AEFeinstein/Swadge-Programmer-Chainsaw/swadge-programmer/swadge-programmer.kicad_pcb

## KiCad design swadge-programmer/swadge-programmer.kicad_pcb (2021-10-04)

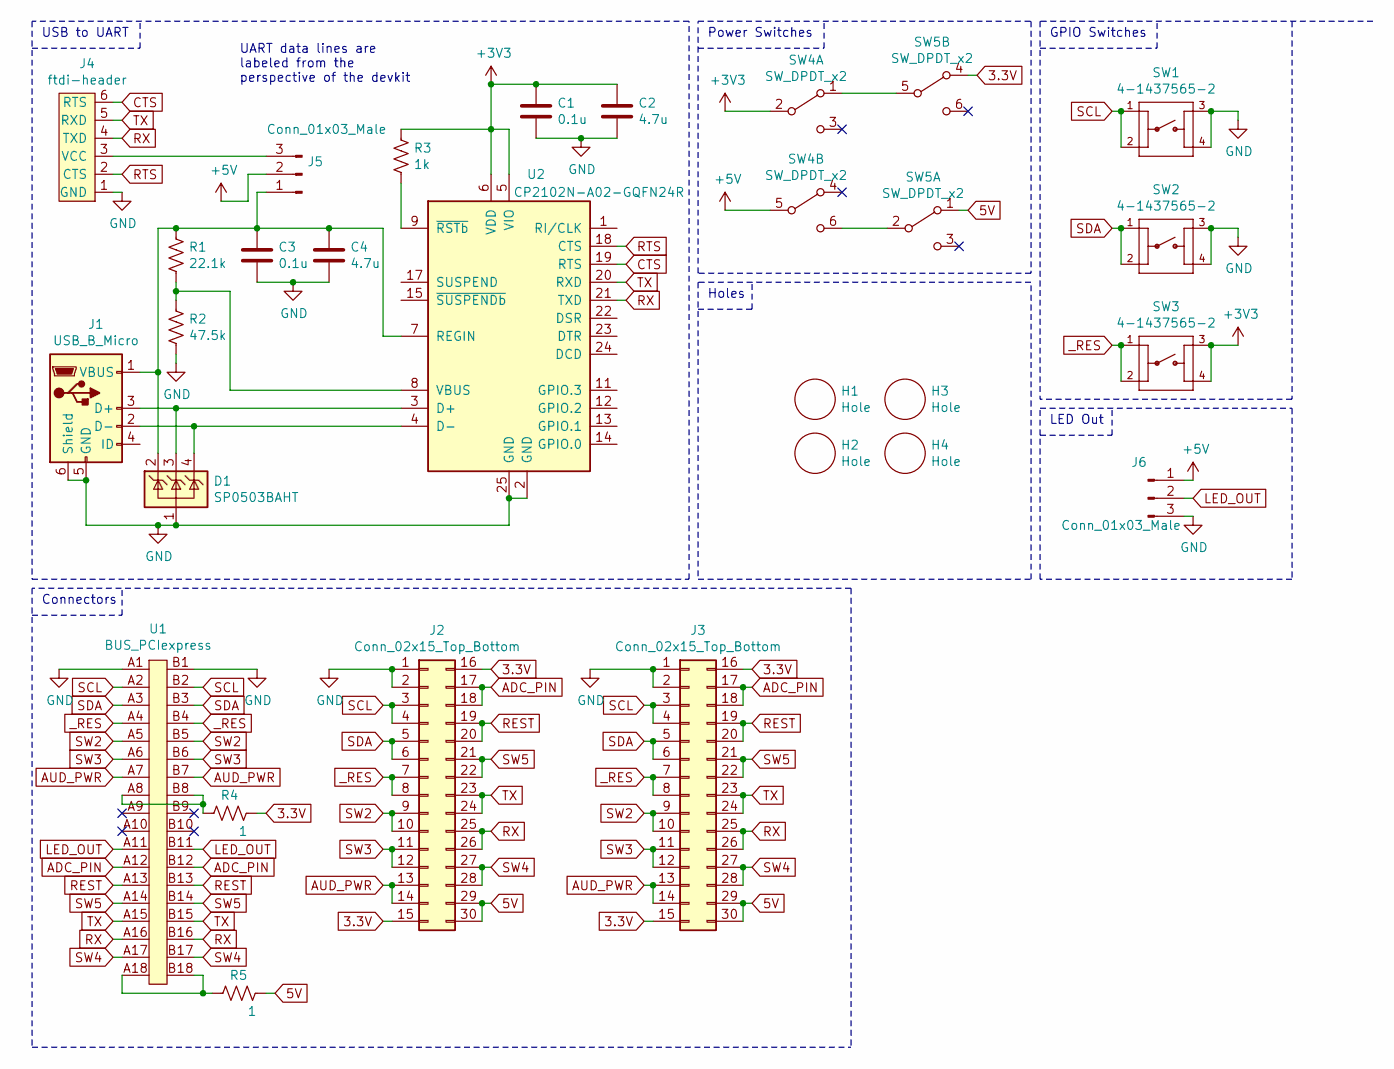
[picture p1: schematic swadge-programmer.sch]

Parts:
C1, C3: 0.1u; C_0603_1608Metric; Digikey 1276-1000-1-ND
C2, C4: 4.7u; C_0603_1608Metric; Digikey 1276-1045-1-ND
D1: SP0503BAHT; SOT-143; Digikey F2715CT-ND
H1, H2, H3, H4: Hole; Digikey 2042-1007-ND
J1: USB_B_Micro; USB_Micro-B_Molex_47346-0001; Digikey WM17141CT-ND
J2, J3: Conn_02x15_Top_Bottom; PinHeader_2x15_P2.54mm_Vertical; Digikey S2012EC-15-ND
J4: ftdi-header; Digikey n/a
J5, J6: Conn_01x03_Male; PinHeader_1x03_P2.54mm_Vertical; Digikey 1849-1003-ND
R1: 22.1k; R_0603_1608Metric; Digikey RMCF0603FT22K1CT-ND
R2: 47.5k; R_0603_1608Metric; Digikey P47.5KHCT-ND
R3: 1k; R_0603_1608Metric; Digikey 311-1.00KHRCT-ND
R4, R5: 1; R_Axial_DIN0207_L6.3mm_D2.5mm_P10.16mm_Horizontal; Digikey RNF14FTD1R00CT-ND
SW1, SW2, SW3: 4-1437565-2; SW_4-1437565-2; MPN FSM4JSMATR; Digikey 450-1759-1-ND
SW4, SW5: SW_DPDT_x2; JS202011CQN; Digikey 401-2001-ND
U1: BUS_PCIexpress; 10018784-10210TLF; Digikey 609-2029-ND
U2: CP2102N-A02-GQFN24R; QFN-24-1EP_4x4mm_P0.5mm_EP2.6x2.6mm; Digikey 336-5888-1-ND

Connections:
3.3V: J2.15, J2.16, J3.15, J3.16, R4.2, SW5.4 (A)
5V: J2.29, J2.30, J3.29, J3.30, R5.2, SW5.1 (A)
+3V3: C1.1, C2.1, R3.2, SW3.3, SW3.4, SW4.2 (B), U2.5 (VIO), U2.6 (VDD)
+5V: J5.2, J6.1, SW4.5 (B)
ADC_PIN: J2.17, J2.18, J3.17, J3.18, U1.A12, U1.B12
AUD_PWR: J2.13, J2.14, J3.13, J3.14, U1.A7, U1.B7
CTS: J4.6 (RTS), U2.19 (RTS)
GND: C1.2, C2.2, C3.2, C4.2, D1.1 (A), J1.5 (GND), J1.6 (Shield), J2.1, J2.2, J3.1, J3.2, J4.1 (GND), J6.3, R2.2, SW1.3, SW1.4, SW2.3, SW2.4, U1.A1, U1.B1, U2.2 (GND), U2.25 (GND)
LED_OUT: J6.2, U1.A11, U1.B11
unnamed: C3.1, C4.1, D1.2 (K), J1.1 (VBUS), J5.1, R1.1, U2.7 (REGIN)
unnamed: D1.3 (K), J1.3 (D+), U2.3 (D+)
unnamed: D1.4 (K), J1.2 (D-), U2.4 (D-)
unnamed: J4.3 (VCC), J5.3
unnamed: R1.2, R2.1, U2.8 (VBUS)
unnamed: R3.1, U2.9 (~RSTb)
unnamed: R4.1, U1.A8, U1.B8
unnamed: R5.1, U1.A18, U1.B18
unnamed: SW4.1 (A), SW5.5 (B)
unnamed: SW4.6 (C), SW5.2 (B)
REST: J2.19, J2.20, J3.19, J3.20, U1.A13, U1.B13
RTS: J4.2 (CTS), U2.18 (CTS)
RX: J2.25, J2.26, J3.25, J3.26, J4.4 (TXD), U1.A16, U1.B16, U2.21 (TXD)
SCL: J2.3, J2.4, J3.3, J3.4, SW1.1, SW1.2, U1.A2, U1.B2
SDA: J2.5, J2.6, J3.5, J3.6, SW2.1, SW2.2, U1.A3, U1.B3
SW2: J2.9, J2.10, J3.9, J3.10, U1.A5, U1.B5
SW3: J2.11, J2.12, J3.11, J3.12, U1.A6, U1.B6
SW4: J2.27, J2.28, J3.27, J3.28, U1.A17, U1.B17
SW5: J2.21, J2.22, J3.21, J3.22, U1.A14, U1.B14
TX: J2.23, J2.24, J3.23, J3.24, J4.5 (RXD), U1.A15, U1.B15, U2.20 (RXD)
_RES: J2.7, J2.8, J3.7, J3.8, SW3.1, SW3.2, U1.A4, U1.B4

Notes on the sheet:
Power Switches
GPIO Switches
USB to UART
Connectors
Holes
UART data lines are labeled from the perspective of the devkit
LED Out

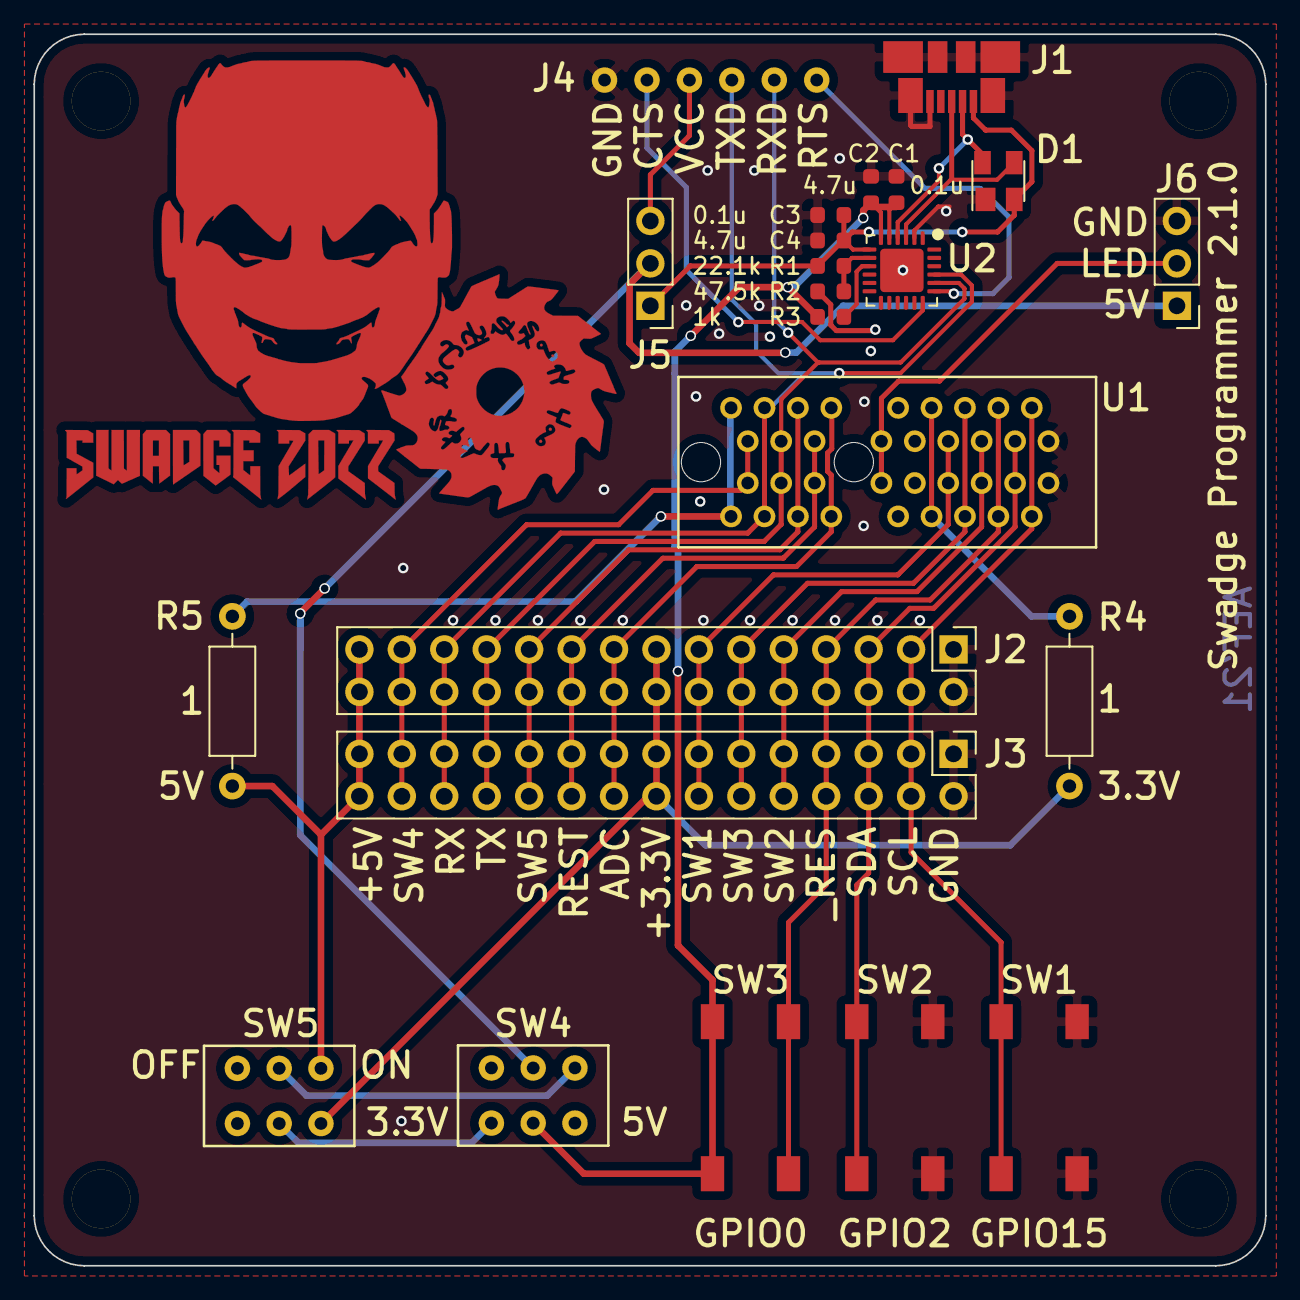
[picture p2: board swadge-programmer.kicad_pcb from above]

Board: 2 copper layers, 73.7 x 73.7 mm, 28 parts (0 on the bottom side), 30 nets.

Other parts of the board:
Ref**: Val**; programmer-graphic
