AEFeinstein/Swadge-Programmer-Chainsaw/(commit log)

2021-07-30 Initial commit copied from Swadge 2020 HW repo
    [swadge-programmer.kicad_pcb, swadge-programmer.sch]
2021-08-03 Move and reroute programmer
    [swadge-programmer.kicad_pcb]
2021-08-03 Fix 3D model references
    [swadge-programmer.kicad_pcb]
2021-08-03 Cleanup text and tracks
    [swadge-programmer.kicad_pcb]
2021-08-03 Round corners, clean up text
    [swadge-programmer.kicad_pcb]
2021-08-03 Update text
    [swadge-programmer.kicad_pcb]
2021-08-04 Adjusted PCIe position
    [swadge-programmer.kicad_pcb]
2021-08-04 Added missing vias
    [swadge-programmer.kicad_pcb]
2021-08-17 Added graphic to programmer
    [swadge-programmer.kicad_pcb]
2021-08-17 Added pin for LED OUT
    [swadge-programmer.kicad_pcb, swadge-programmer.sch]
2021-08-18 Updated CP2012n revision
    [swadge-programmer.kicad_pcb, swadge-programmer.sch]
2021-08-18 Added signature
    [swadge-programmer.kicad_pcb]
2021-08-18 Fixed board params
    [swadge-programmer.kicad_pcb]
2021-08-18 Added output directory
    [swadge-programmer-B_Cu.gbl, swadge-programmer-B_Mask.gbs, swadge-programmer-B_Paste.gbp, swadge-programmer-B_SilkS.gbo, swadge-programmer-Edge_Cuts.gm1, swadge-programmer-F_Cu.gtl, swadge-programmer-F_Mask.gts, swadge-programmer-F_Paste.gtp]
2021-08-18 Removed output files, added BOM processor
    [swadge-programmer-B_Cu.gbl, swadge-programmer-B_Mask.gbs, swadge-programmer-B_Paste.gbp, swadge-programmer-B_SilkS.gbo, swadge-programmer-Edge_Cuts.gm1, swadge-programmer-F_Cu.gtl, swadge-programmer-F_Mask.gts, swadge-programmer-F_Paste.gtp]
2021-10-04 Added jumpers to CAD, flipped 5V switch
    [swadge-programmer.kicad_pcb]
